SDU-Vikings-Racing-Team/EL-KiCad-Library/3dmodels/Littelfuse_157-Holder.stp

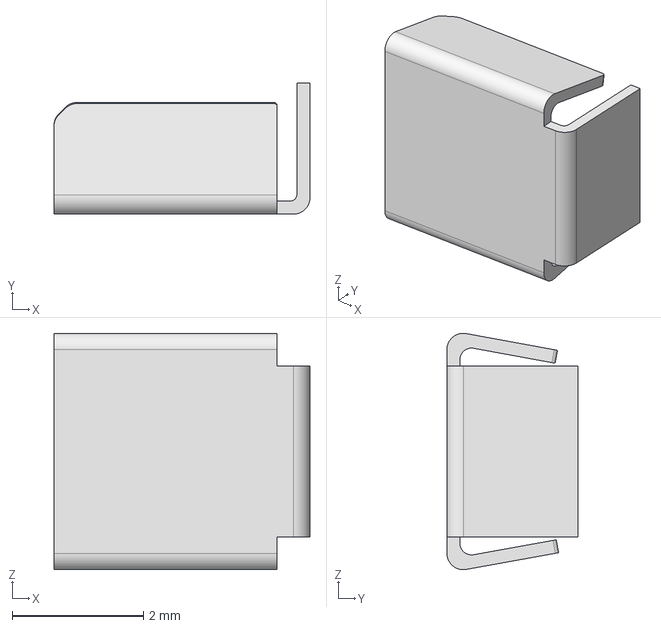
[picture p1: CAD file, 2025-10-03]
3dmodels/Littelfuse_157-Holder.stp
3.90 x 2.00 x 3.60 mm
