SDU-Vikings-Racing-Team/EL-KiCad-Library/3dmodels/BAT48JFILM.stp

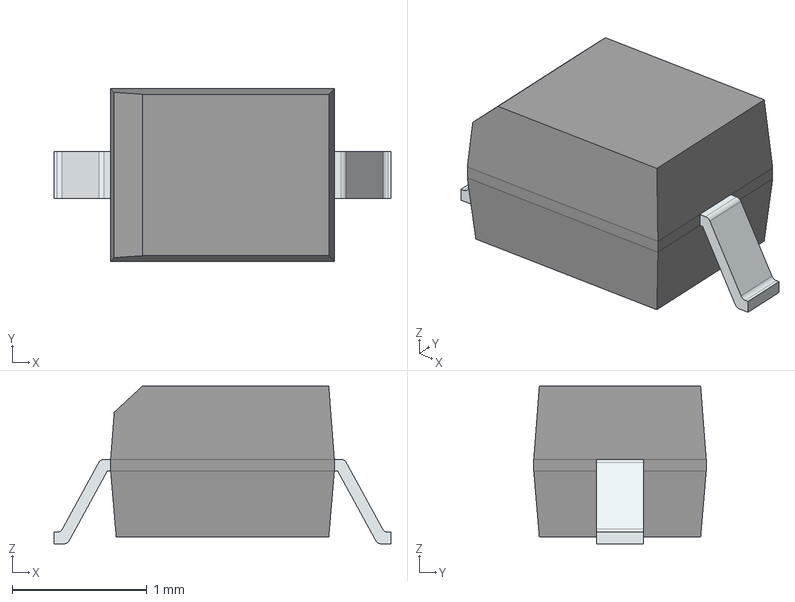
[picture p2: CAD file, 2025-10-03]
3dmodels/BAT48JFILM.stp
2.50 x 1.28 x 1.17 mm
FilletPinL
FilletPinR
