SDU-Vikings-Racing-Team/EL-KiCad-Library/3dmodels/c-1-776266-1-b-3d.stp

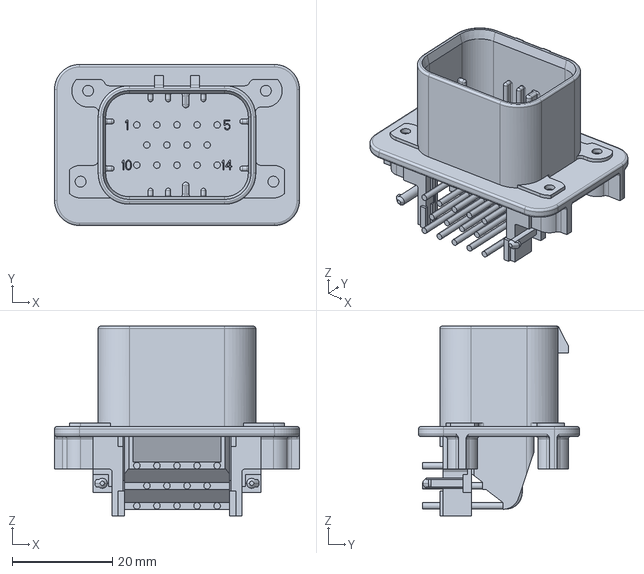
[picture p3: CAD file, 2025-10-03]
3dmodels/c-1-776266-1-b-3d.stp
48.8 x 32.1 x 37.8 mm
