SDU-Vikings-Racing-Team/EL-KiCad-Library/3dmodels/IPS1-105-L1-L-D.stp

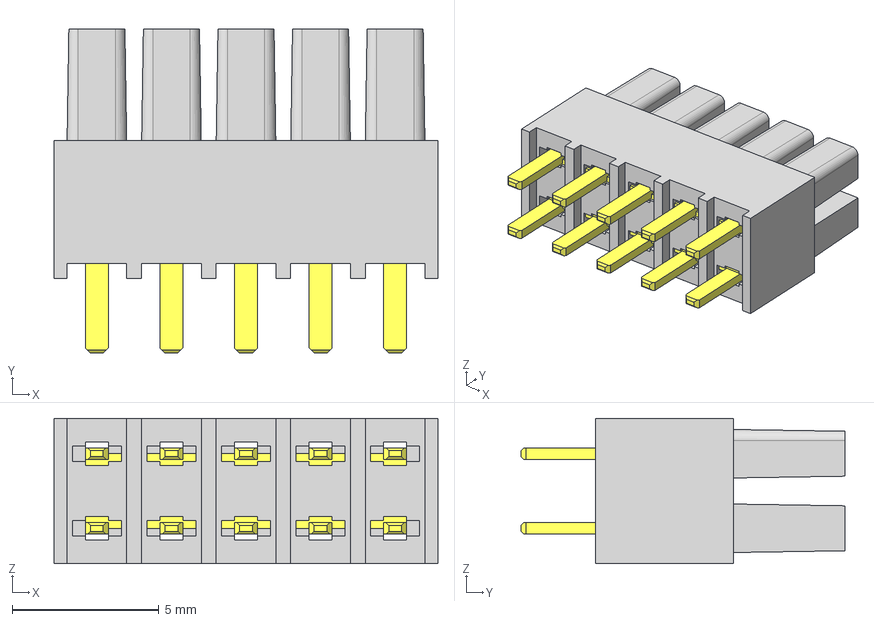
[picture p5: CAD file, 2025-10-03]
3dmodels/IPS1-105-L1-L-D.stp
13.1 x 11.0 x 4.95 mm
_IPS1-105-L1-L-Dt
_IPS1-105-L1-D_pin
