SDU-Vikings-Racing-Team/EL-KiCad-Library/3dmodels/c-1-776228-1-e-3d.stp

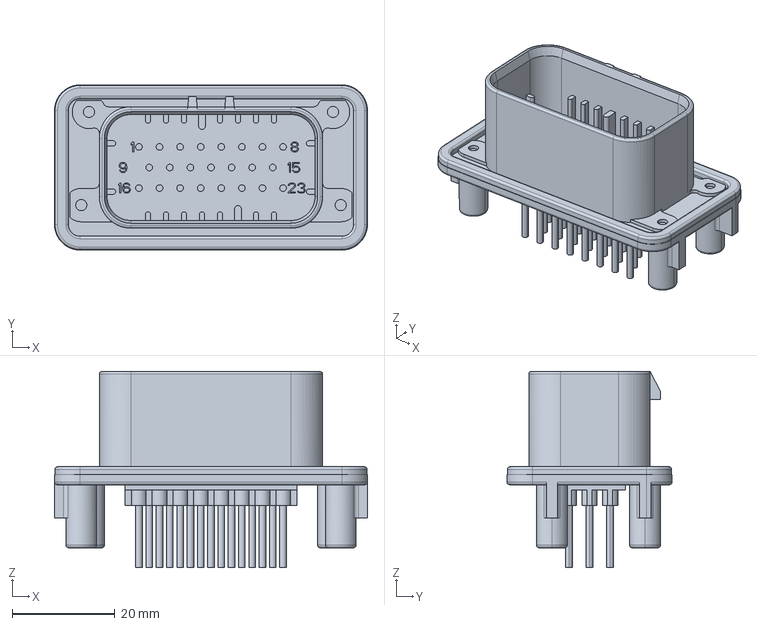
[picture p6: CAD file, 2025-10-03]
3dmodels/c-1-776228-1-e-3d.stp
60.8 x 32.1 x 38.1 mm
