SDU-Vikings-Racing-Team/EL-KiCad-Library/3dmodels/ESD5Z5.0T1G.stp

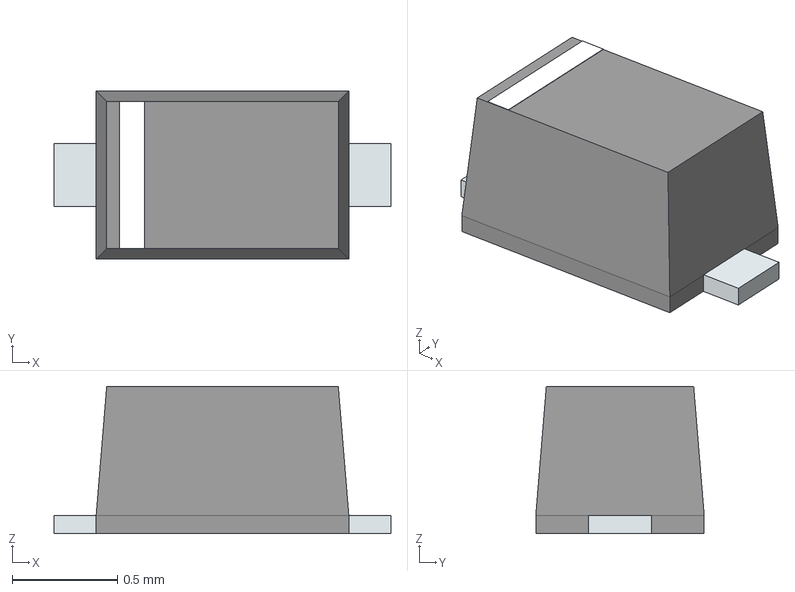
[picture p7: CAD file, 2025-10-03]
3dmodels/ESD5Z5.0T1G.stp
1.60 x 0.8 x 0.7 mm
PinKIdent
PinK
PinA
