SDU-Vikings-Racing-Team/EL-KiCad-Library/3dmodels/DMPH6050SPD-13.stp

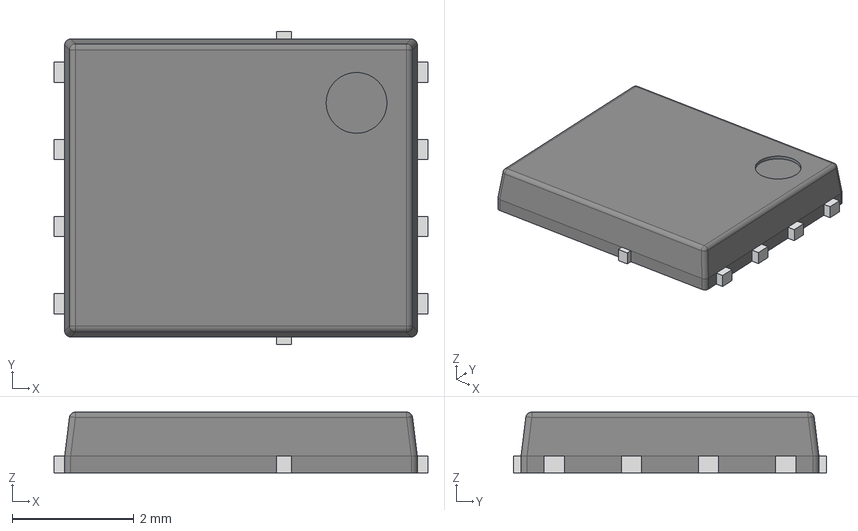
[picture p8: CAD file, 2025-10-03]
3dmodels/DMPH6050SPD-13.stp
6.15 x 5.15 x 1.00 mm
