SDU-Vikings-Racing-Team/EL-KiCad-Library/3dmodels/IPT1-115-01-L-D.stp

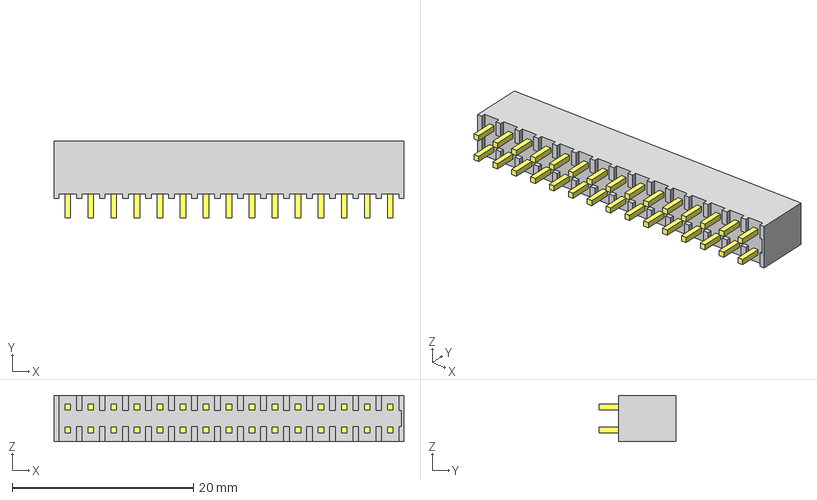
[picture p9: CAD file, 2025-10-03]
3dmodels/IPT1-115-01-L-D.stp
38.6 x 8.51 x 5.08 mm
_IPT1-115-01-L-D_terminal
_IPT1-115-01-D_pin
