SDU-Vikings-Racing-Team/EL-KiCad-Library/3dmodels/IPT1-105-01-L-D.stp

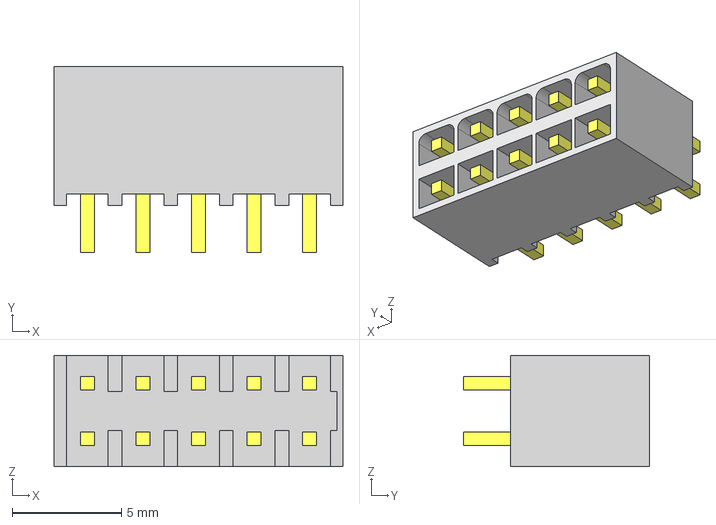
[picture p10: CAD file, 2025-10-03]
3dmodels/IPT1-105-01-L-D.stp
13.2 x 8.51 x 5.08 mm
_IPT1-105-01-L-D_terminal
_IPT1-105-01-D_pin
