SDU-Vikings-Racing-Team/EL-KiCad-Library/3dmodels/IP4220CZ6,125.stp

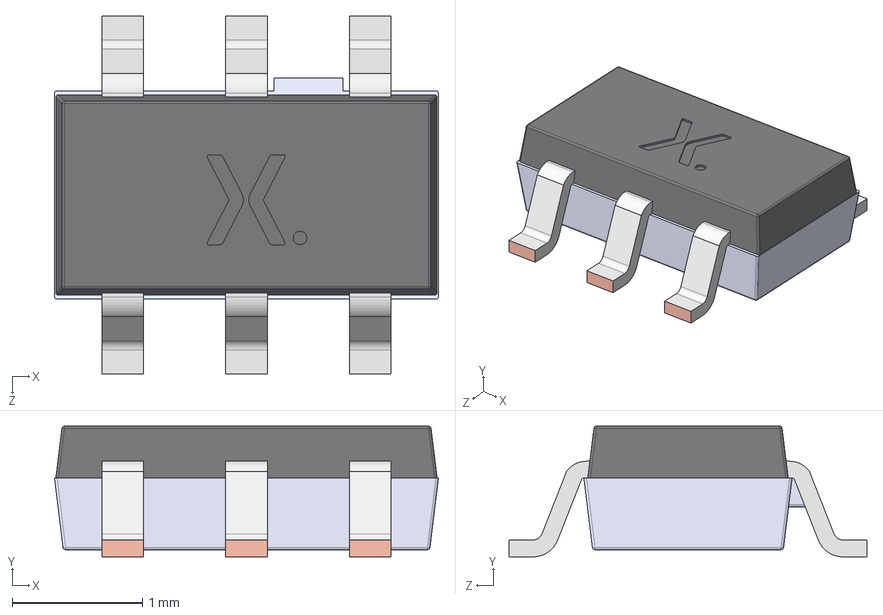
[picture p11: CAD file, 2025-10-03]
3dmodels/IP4220CZ6,125.stp
2.95 x 1.01 x 2.75 mm
SOT457 Lower body
SOT457 Lead x 6
SOT457 Upper body
