SDU-Vikings-Racing-Team/EL-KiCad-Library/3dmodels/MCP6561RT-E_OT.stp

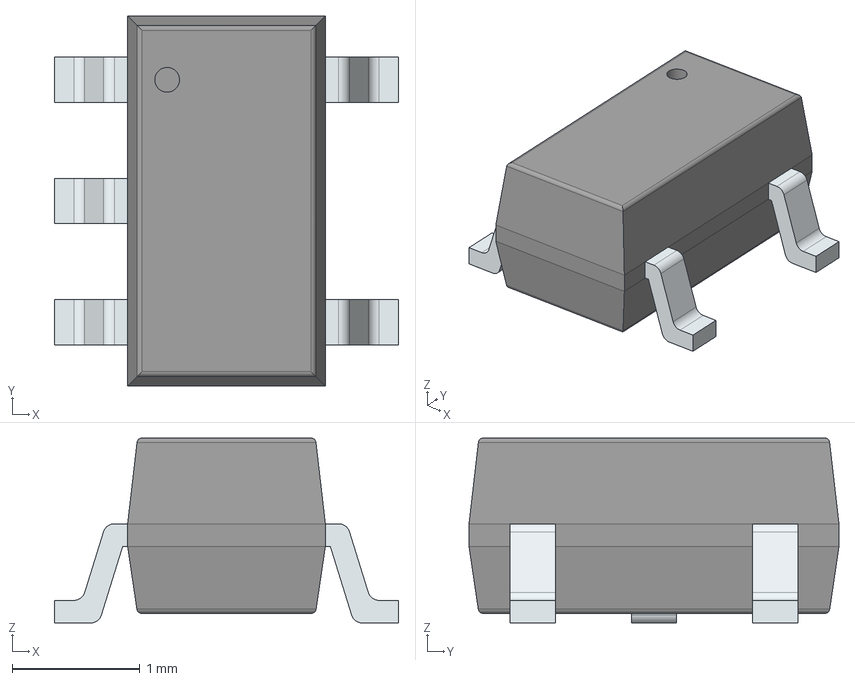
[picture p12: CAD file, 2025-10-03]
3dmodels/MCP6561RT-E_OT.stp
2.70 x 2.90 x 1.45 mm
PinsArrayL
PinsArrayR
