SDU-Vikings-Racing-Team/EL-KiCad-Library/3dmodels/c-1-776163-1-s-3d.stp

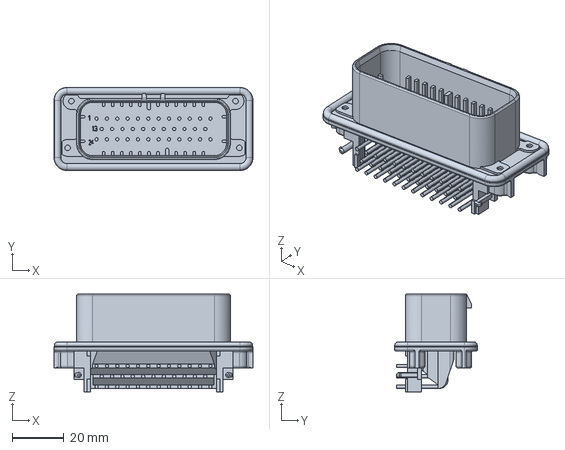
[picture p13: CAD file, 2025-10-03]
3dmodels/c-1-776163-1-s-3d.stp
76.9 x 32.1 x 37.8 mm
