SDU-Vikings-Racing-Team/EL-KiCad-Library/3dmodels/FUSE_NANO2.step

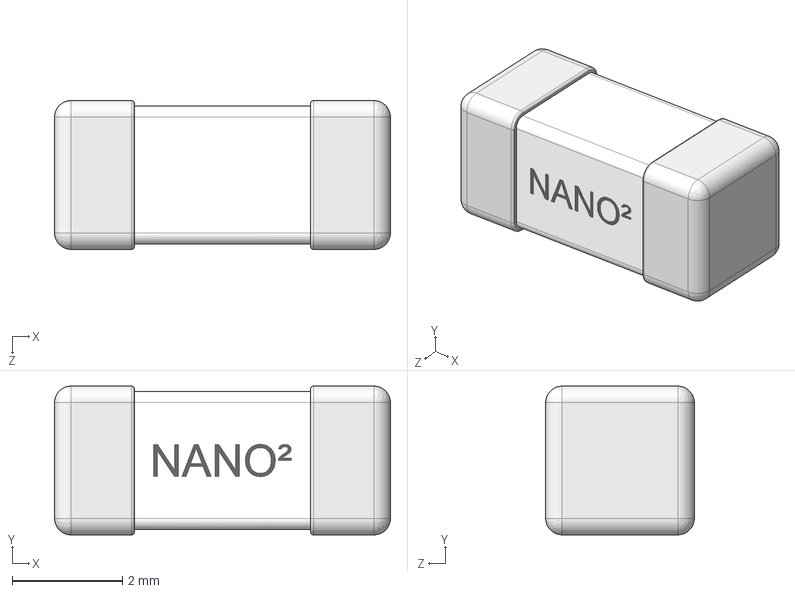
[picture p14: CAD file, 2025-10-03]
3dmodels/FUSE_NANO2.step
6.10 x 2.70 x 2.70 mm
