SDU-Vikings-Racing-Team/EL-KiCad-Library/3dmodels/TLV7044RTER.stp

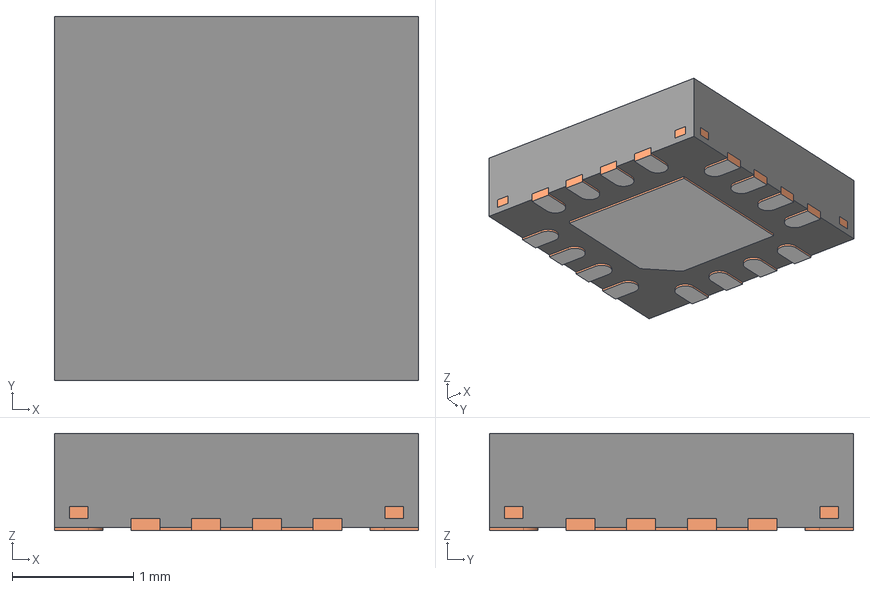
[picture p15: CAD file, 2025-10-03]
3dmodels/TLV7044RTER.stp
3.00 x 3.00 x 0.8 mm
BODY-QFN
FRAME-RTE0016C
PIN1-ID
