SDU-Vikings-Racing-Team/EL-KiCad-Library/3dmodels/2V7002WT1G.stp

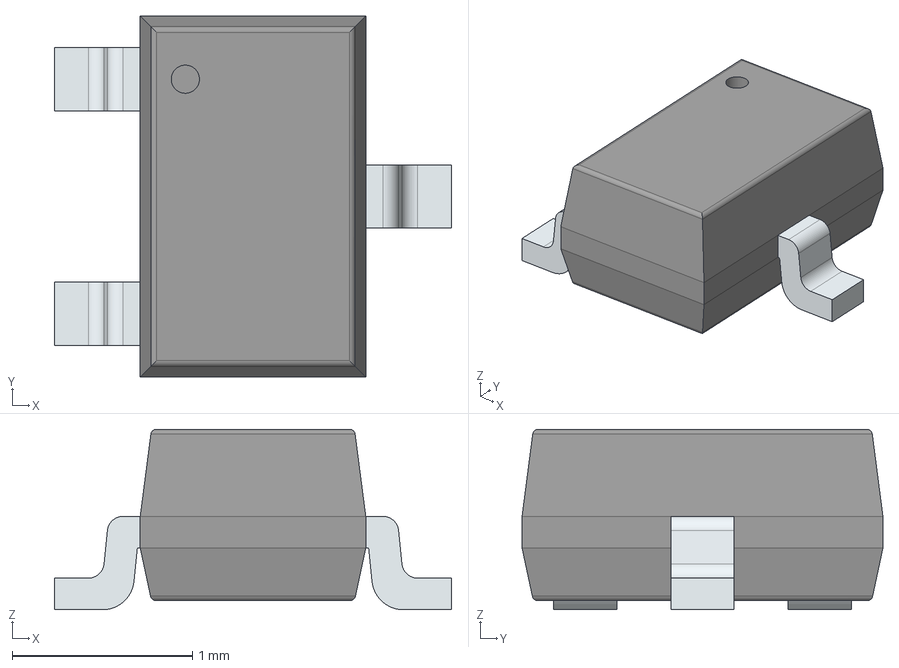
[picture p16: CAD file, 2025-10-03]
3dmodels/2V7002WT1G.stp
2.20 x 2.00 x 1.00 mm
PinsArrayL
FilletPinR
