SDU-Vikings-Racing-Team/EL-KiCad-Library/3dmodels/c-1-776231-1-d-3d.stp

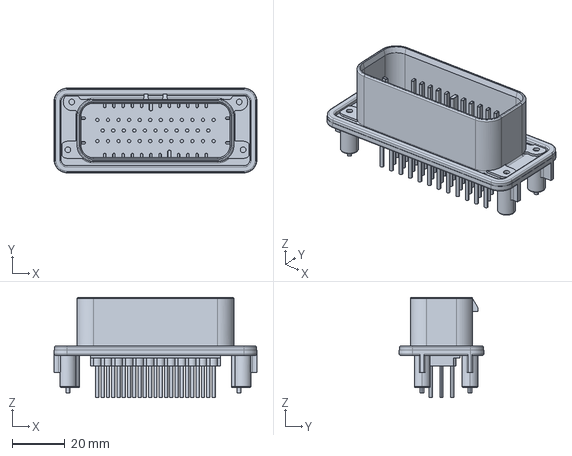
[picture p17: CAD file, 2025-10-03]
3dmodels/c-1-776231-1-d-3d.stp
76.9 x 32.1 x 38.0 mm
