SDU-Vikings-Racing-Team/EL-KiCad-Library/3dmodels/NTCAFLEX05103HH_colored.stp

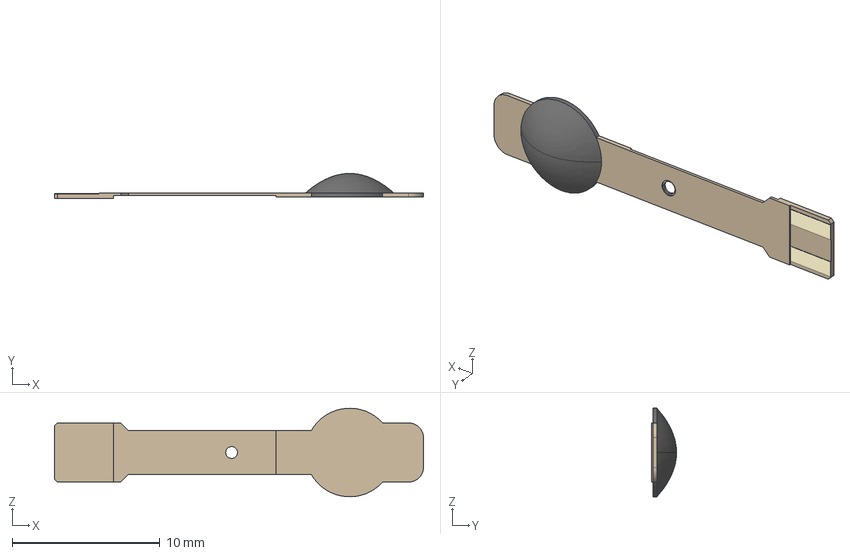
[picture p18: CAD file, 2025-10-03]
3dmodels/NTCAFLEX05103HH_colored.stp
25.0 x 1.70 x 6.00 mm
