SDU-Vikings-Racing-Team/EL-KiCad-Library/(list of files, cad)

Other CAD files:
3dmodels/c-1-776262-1-c-3d.stp
3dmodels/c-1-776087-1-l-3d.stp
3dmodels/ESD5Z5.0T5G.stp
3dmodels/171930601.stp
3dmodels/173010335.stp
3dmodels/173010535.stp
3dmodels/18024215401H.stp
3dmodels/450301014042.stp
3dmodels/450404015514.stp
3dmodels/61301011821.stp
3dmodels/61301021821.stp
3dmodels/61900311121 (rev1).stp
3dmodels/61900311621 (rev1).stp
3dmodels/61900511121 (rev1).stp
3dmodels/61900511621 (rev1).stp
3dmodels/649002013322 (rev1).stp
3dmodels/649002013322_rev1.stp
3dmodels/64900211122_rev1.stp
3dmodels/649002113322 (rev1).stp
3dmodels/649002127222 (rev1).stp
3dmodels/64900221122 (rev1).stp
3dmodels/649002227222 (rev1).stp
3dmodels/649003013322 (rev1).stp
3dmodels/64900311122 (rev1).stp
3dmodels/649004113322 (rev1).stp
3dmodels/64900421122 (rev1).stp
3dmodels/649004227222 (rev1).stp
3dmodels/649006113322 (rev1).stp
3dmodels/64900621122 (rev1).stp
3dmodels/649006227222 (rev1).stp
3dmodels/649008113322 (rev1).stp
3dmodels/64900821122 (rev1).stp
3dmodels/649008227222 (rev1).stp
3dmodels/649012113322 (rev1).stp
3dmodels/64901221122 (rev1).stp
3dmodels/649016113322 (rev1).stp
3dmodels/64901621122 (rev1).stp
3dmodels/649024113322 (rev1).stp
3dmodels/64902421122 (rev1).stp
3dmodels/662002113322_rev1.stp
3dmodels/66200221122_rev1.stp
3dmodels/662004013322_Download_STP_662004013322_rev1.stp
3dmodels/662004113322 (rev1).stp
3dmodels/66200421022 (rev1).stp
3dmodels/66200421122 (rev1).stp
3dmodels/662005013322_Download_STP_662005013322_rev1.stp
3dmodels/662005013322_rev1.stp
3dmodels/66200511122_rev1.stp
3dmodels/662006013322_Download_STP_662006013322_rev1.stp
3dmodels/662006113322 (rev1).stp
3dmodels/66200621122 (rev1).stp
3dmodels/662008113322 (rev1).stp
3dmodels/66200821122 (rev1).stp
3dmodels/662012113322_rev1.stp
3dmodels/66201221122_rev1.stp
3dmodels/662104130822_Downloads_STP_662104130822_rev1.stp
3dmodels/662104236022 (rev1).stp
3dmodels/662105130822_Downloads_STP_662105130822_rev1.stp
3dmodels/662106130822_Downloads_STP_662106130822_rev1.stp
3dmodels/687308124422_Download_STP_687308124422_rev1_nocap.stp
3dmodels/7461097.stp
3dmodels/7461098.stp
3dmodels/7461099.stp
3dmodels/7461147.stp
3dmodels/7461383.stp
3dmodels/831066629.stp
3dmodels/9775026360R.stp
3dmodels/TBD62783AFNG,EL.stp
