SDU-Vikings-Racing-Team/EL-KiCad-Library/(commit log)

2025-09-11 Added graphics to footprints
2025-09-15 Creation of basic library structures. Added dummy symbols and footprints for github to track the folders
2025-10-03 Crazy amount of components and references between symbols, footprints and 3d models
    [171930601.stp, 173010335.stp, 173010535.stp, 18024215401H.stp, 2V7002WT1G.stp, 450301014042.stp, 450404015514.stp, 61301011821.stp]
2025-10-03 Bump
    - Renaming footprints subfolders for consistency.
